mustafaAbdAlRazzak/Hephaestus-HydroTemp/docs/images/hmi/hmi2.png

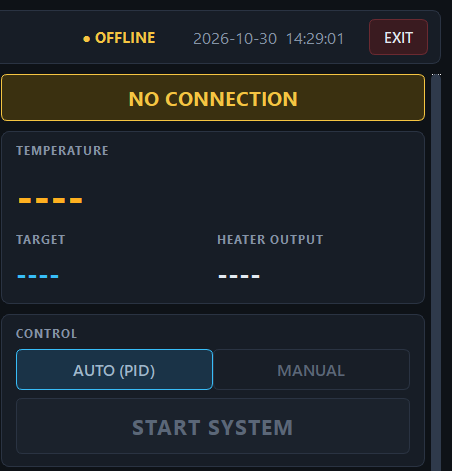
docs/images/hmi/hmi2.png
