mustafaAbdAlRazzak/Hephaestus-HydroTemp/docs/images/hmi/hmi3.png

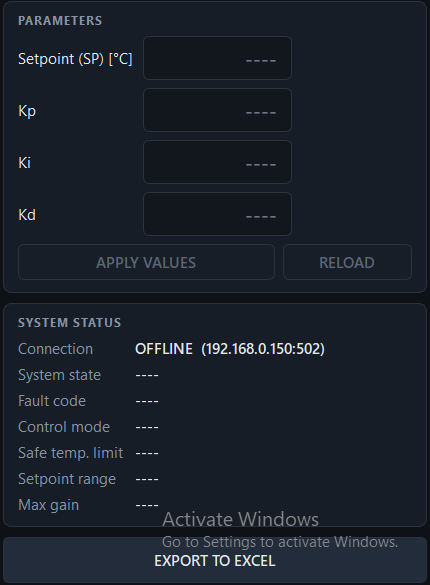
docs/images/hmi/hmi3.png
