mustafaAbdAlRazzak/Hephaestus-HydroTemp/docs/images/hmi/hmi4.png

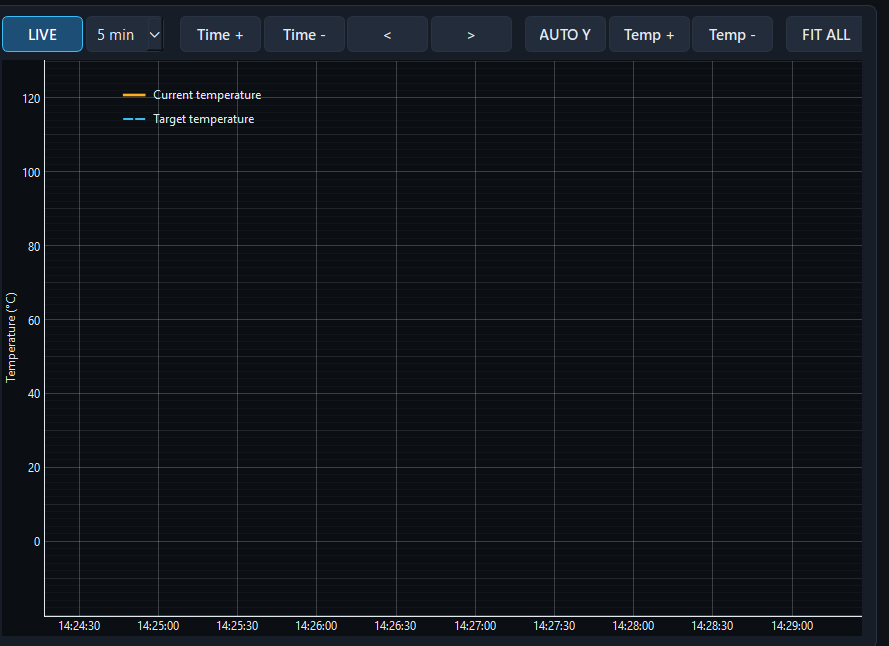
docs/images/hmi/hmi4.png
