mustafaAbdAlRazzak/Hephaestus-HydroTemp/docs/images/diagrams/wiring-diagram.png

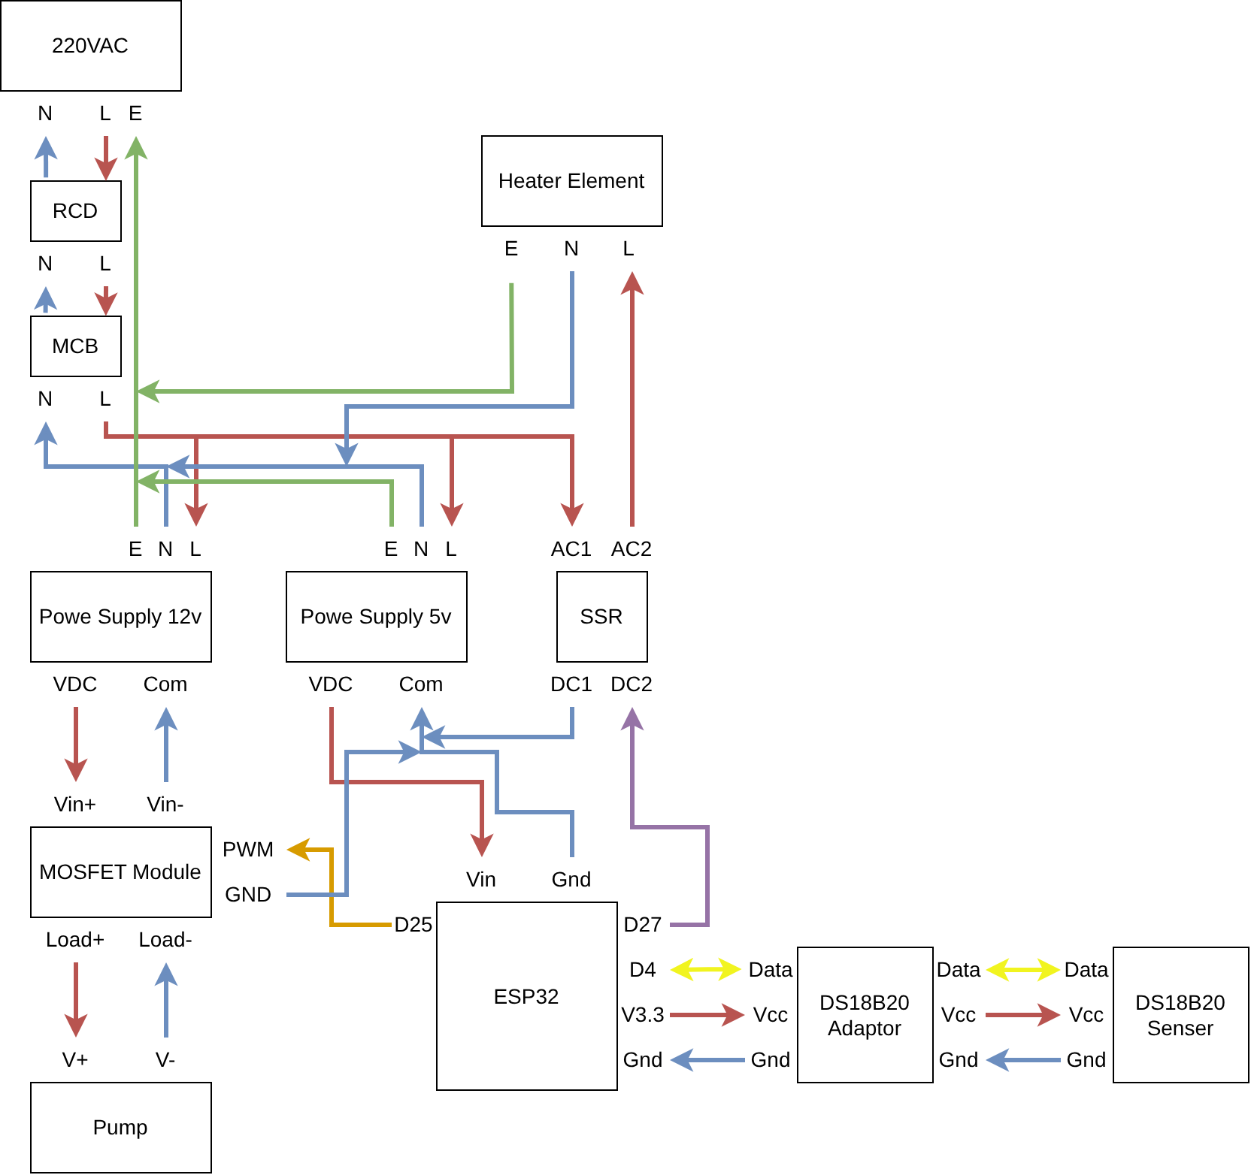
docs/images/diagrams/wiring-diagram.png
