mustafaAbdAlRazzak/Hephaestus-HydroTemp/(commit log)

2026-10-30 Enhance README with UI flow charts
    Added UI section with flow chart images to README.
2026-11-12 Update control strategy section in README
    Clarified PID control strategy details in README.
