mustafaAbdAlRazzak/Hephaestus-HydroTemp/(notices)

Notices in the files:
README.md:
License: MIT
